zmaragdus/PortablePowerSupply/SPECIFICATIONS.md

## Top-Level Goals

Below are the overall goals of the project. All other specifications should work toward fulfilling these top-level specifications

- The unit should be the size of a large laptop charger.
- The unit should be capable of producing an adjustable output up to 27VDC and 2A (55W).
- The unit should have controls for adjusting the voltage and current limits.
- The unit should have a display to show the output voltage/current
- The unit should provide an auxiliary fixed output of 5V and 100mA (0.5W).

## Power Path / Conversion

#### Line Input

- Should be "universal" power input (100-250VAC, 47-63Hz)
- Development testing will show if X/Y capacitors and/or common-mode chokes are required.
- Line will be double fused.
- Line will have series SPST switch to cut off power.
- Three-prong connection will be used.

#### Primary AC Conversion

- Passive diode bridge will rectify AC into positive-only sine wave
- PFC converter will produce a bus voltage no less than 30V and no more than 60V 
- PFC converter must accommodate both 50Hz and 60Hz
- PFC converter will provide, at minimum, basic isolation (will use flyback topology)

#### Primary Switching Regulator

- Monolithic switching converter will produce OUT + 1V for main power supply output.
- Main PS output control performance will need to be slow to maintain good phase margin across wide output range.
- Can use either precision current DAC or ride-on-top analog circuit to follow OUT voltage.
- Use small PCB LEDs (internally-visible) to indicate outputs in regulation.

#### Linear Post-Regulator

- Output current limit must be adjustable.
- No remote sense / cable compensation for initial design.
- Precision current DAC will source/sink feedback current for coarse adjustment
- Digital potentiometer will adjust feedback resistance for fine adjustment
- Analog switch will toggle range
- Digital potentiometer will adjust current limit node.

#### Printed Circuit Board / Hardware

- To facilitate hand-soldering, it is preferred (though not required) to use either one size up in footprint size (e.g. an 0805 footprint for an 0603 capacitor) or the "hand soldering" footprint for the same size.
- No BGAs will be used. Any parts with hidden exposed pads to be soldered require a through hole large enough to get a small soldering iron tip through the other side to touch the pad for manual soldering.
- Minimum via size is 0.3mm, minimum trace/space is 0.15mm
- Layer 2 is full ground plane. Routing discipline will be used to effect minimal interference between power, analog, and digital sections.
- Vias should not be soldermasked over unless properly plugged/filled.

#### Standard Components

- Minimum resistor/capacitor size is 0402 (Imperial).
- Resistors with no extra information displayed or added as internal fields are assumed to be rated at 0603 size, 1%, 50V, 0.1W. Deviations from this will be explicitly noted.
- Resistors of other sizes assumed to have the following power ratings if not specified: 0402 = 0.06W, 0805 = .12W, 1206 = 0.25W
- Resistors with any non-standard rating(s) will have those characteristics noted as extra fields in the schematic symbol properties.
- All capacitors should have temperature range equivalent to ceramic class II X5R or better. Exceptions will be explicitly called out. (X5R or better preferred for ceramic capacitors, due to superior derating characteristics.)
- Capacitors with no extra information displayed are assumed to be ceramic MLCC type, 0603 size, and rated for 16V. Deviations from this will be explicitly noted.
- Capacitors that are part of sensitive signal circuits (control, timing, resonance, etc.) should be of class I construction (C0G or NP0 rating preferred).

## Mechanical / User

#### Line Input

- If a non-grounded connection is acceptable, plug will be IEC C8. If ground is necessary, plug will be IEC C6
- AC line input will be switch-toggled and protected (circuit breaker or user-replacable fuse)
- No ground fault monitoring.

#### Housing

- Case material undetermined at this point. Will need to be at least heat-resistant plastic. If metal, case will be earth grounded.
- Two sets of openings for airflow, one of those will have a fan mounted internally.
- All screws will be metric-threaded with a standard torx drive.
- All externally-accessible screws will be countersunk flush with case or recessed into a counterbored hole.

#### Power Output

- Main power output through two banana / mounting posts on end. Posts will accept banana plugs or wires (example: Pomona 5018 series).
- Banana posts will be standard 3/4" apart to facilitate common adapters. Could use dual post unit.
- Providing earth ground connection still under consideration.
- Auxiliary power output through two screw terminals on end.

#### User Interface

- Output voltage and current limits adjusted via independent rotary dials.
- Rotary dials connected to potentiometer.
- Output enabled/disabled through latching pushbutton.
- LED indicator for power states: LED on for output activated, LED off for output deactivated, and LED blinking for fault.
- Digital display must, at minimum, show actual output voltage and current. If additional area / capabilities exist, can also display output setpoints and any active faults (either a numeric code or an explicit statement).

## Software

The computing platform will be an Arduino Nano Every, using the standard Arduino offline IDE / compiler. This is to accommodate hobbyist and amateur usage.

If the Arduino Nano Every proves to have insufficient processing and/or memory capabilities, the ST Nucleo L432K will be used. Software will need to be migrated over to the Mbed platform in that case.

## Documentation

#### Text

LaTeX will be the primary language used for generating documentation.

The documentation will contain links to the datasheets of all

- ICs
- non-ceramic capacitors
- inductors
- filter components (e.g. ferrite bead)
- connectors
- user controls (e.g. buttons and wheels)
- PCB material specifications
- other electronic modules (e.g. display unit)

The datasheets for all ICs and modules should be downloaded and stored in the "hw/ds" folder.

#### Images

Images created in a software program will be saved as vector images (.svg) and converted to PDF files for inclusion in the LaTeX files. Use the same filename for both the .svg file and the .pdf file. This allows for batch regeneration of all images.

Images captured by a camera shall be saved as JPEG files.

All images shall be stored in the "doc/img" folder.
