zmaragdus/PortablePowerSupply/hw/sim/LT3798_design.ods

 | Value | Units
Transformer Information
NPS (pri:sec turns ratio) | 3 | -
NPB (pri:bias turns ratio) | 6 | -
LPRI (primary inductance) | 200 | uH
LLEAK (leakage inductance) | 5.9 | uH
Input/Output Information
Min Input Voltage | 100 | VAC
Input Voltage | 120 | VAC
Max Input Voltage | 130 | VAC
Target Output Voltage | 35 | VDC
Target Output Current | 2.2 | A
Diode Forward Drop | 0.55 | VDC
Rsense | 0.02 | ohm
D | 0.382 | -
IOUT(MAX) (peak) | 4.412
IOUT(MAX) (average half cycle) | 2.09589340323285
