zmaragdus/PortablePowerSupply/mech/CostEstimate.md

Initial Cost Estimate:

PCB: $45 / board, [RushPCB](https://order.rushpcb.com/#/ProtosSpecial) prototype run, 20 sq. in., 6 layers

Isolation transformer: $25 at Arrow Electronics

ICs: $70 ish at Arrow Electronics

Arduino / mbed SoM: $20-40 (many boards available on the [mbed website](https://os.mbed.com)

PCB components: $70 ish at Arrow Elecronics

Display unit: $30

Enclosure: $30?

Physical connectors / interfaces: $100 (power protection / filtering is surprisingly expensive)

Initial cost estimate: about $400 / unit
