zmaragdus/PortablePowerSupply/hw/ds/Wurth_750315827.pdf

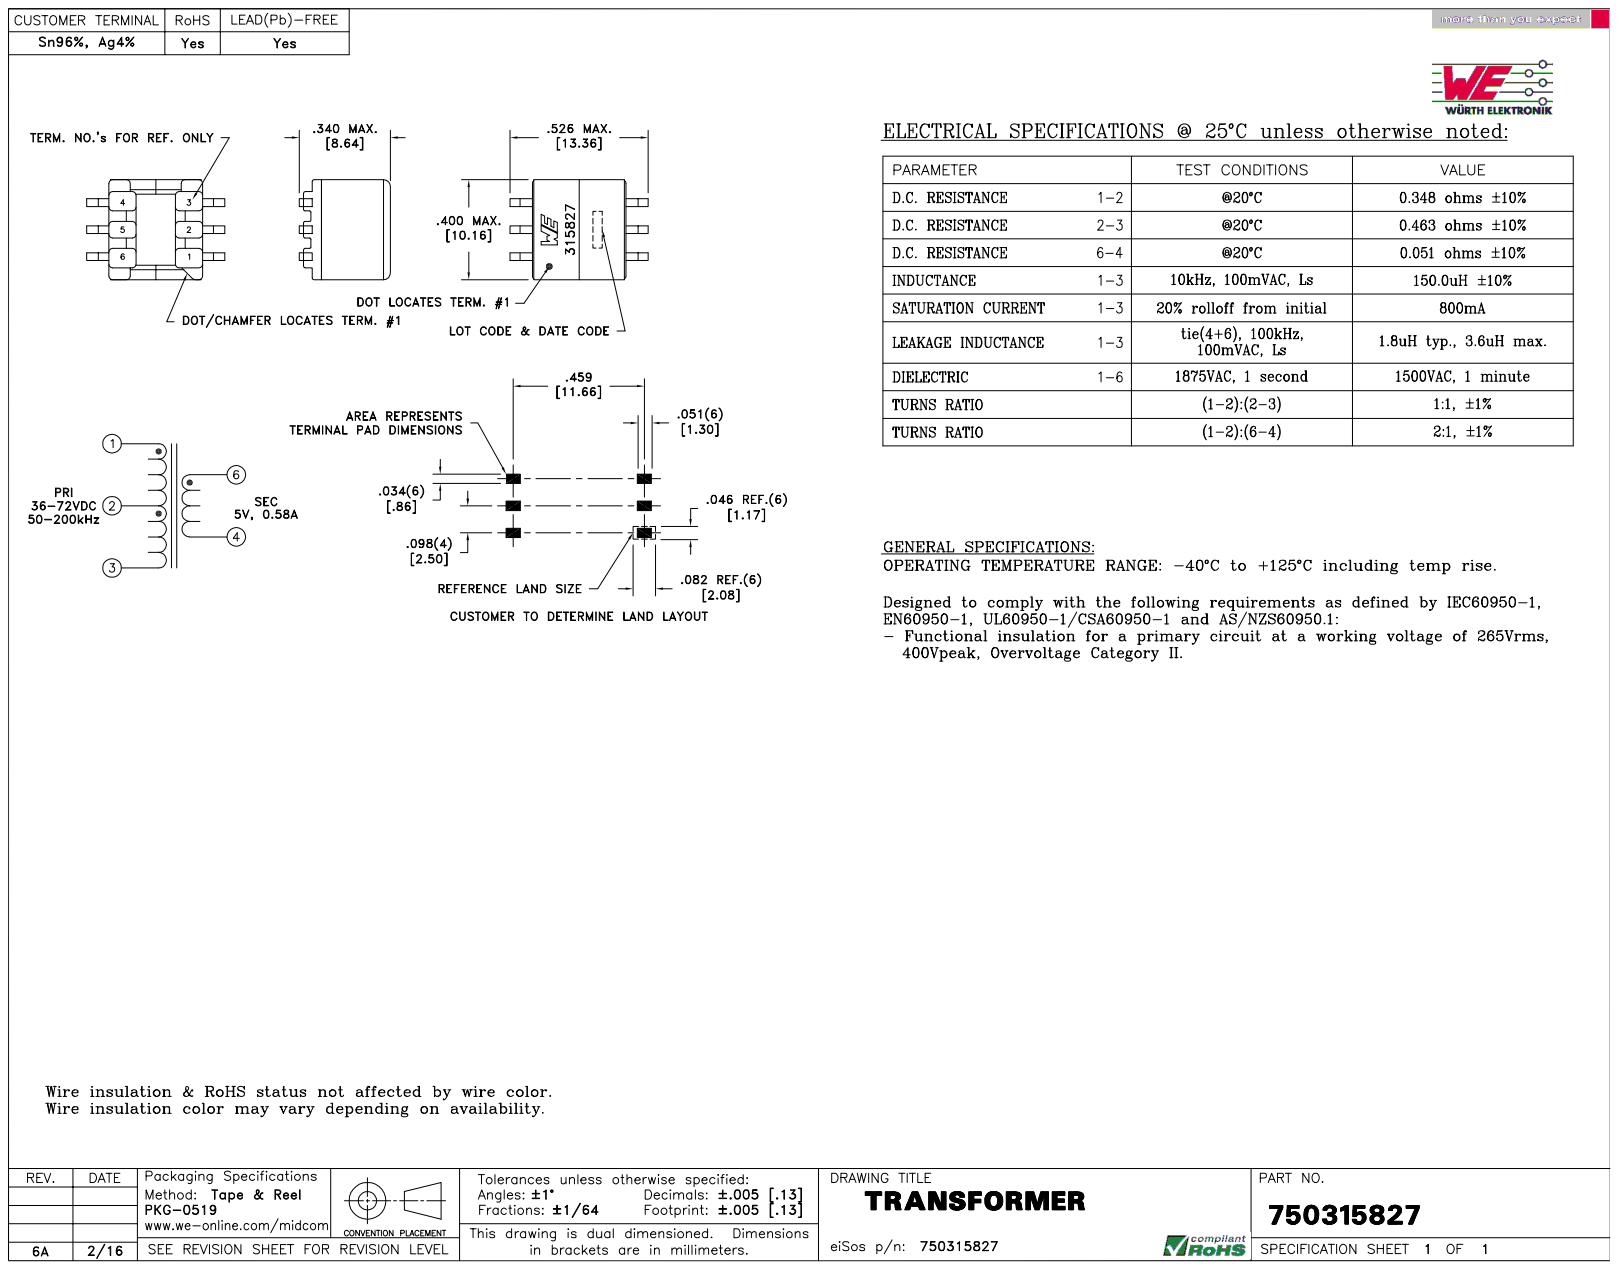
[picture p1: page 1]
