zmaragdus/PortablePowerSupply/hw/sim/constant_current_load.asc

Q1: npn; 2N3904
Q2: npn; 2N3904
R1: res; 2700
R3: res; 10
V1: voltage; PULSE(0 27 0 100m 1n 200m 400m)
V2: voltage; 5
Named nets: 0
.tran 100m
.temp -10 5 20 35 50 65 80 95 110
