zmaragdus/PortablePowerSupply/(threads)

Thread 5 (2020-05-26):

Generate DAC Code Equations

zmaragdus, 2020-05-26:
Create equations for current DAC outputs to adjust voltages / current limit.

zmaragdus, 2020-05-26:
Download "LTPowerCAD II" from Analog Devices' website. They have a tool for calculating LTC7106 operation under "toolbox"

Thread 6 (2020-05-26):

Choose ADC

zmaragdus, 2020-05-26:
Need ADC for measuring up to four rails: switching regulator output voltage, linear regulator output voltage, linear regulator current monitor, linear regulator temperature monitor.

Can use precision resistor dividers to bring voltage in-range.

Possible voltage supply rails: 36V, 5V, 3.3V, 1.8V

I2C or SPI preferred. (Will depend on selected microcontroller)

zmaragdus, 2020-05-26:
Cheapest single-channel ADC on Analog Devices' website is almost $6. Will be cheaper to get a multi-channel unit.

Target bit range in excess of 14 bits.

Rough calculations: for 14-bit converter with 4.096V reference, LSB size is 250uV. If max switcher voltage is 28V, that gives an ideal resolution of about 1.7mV / bit on the primary sw output reading.

zmaragdus, 2020-05-30:
Chose AD7682

Closed 2020-05-30.

Thread 14 (2021-02-10):

Aux Transformer Footprint

zmaragdus, 2021-02-10:
Need footprint for auxiliary output transformer to finish subsystem

part number: Wurth 750315827

datasheet: https://www.we-online.de/katalog/datasheet/750315827.pdf
