zmaragdus/PortablePowerSupply/(commit log)

2020-05-06 Initial Commit
    Initial commit. Already done with a lot of the greater schematic
    [LineInput.sch, LinearReg.sch, PFCBoost.sch, PrimarySW.sch, SupplyAdj.sch, portaPower.kicad_pcb, portaPower.sch]
2020-05-06 Reorg
    Reorganized folder structure
    [LineInput.sch, LinearReg.sch, PFCBoost.sch, PrimarySW.sch, SupplyAdj.sch, portaPower.kicad_pcb, portaPower.sch]
2020-05-07 More work on PFC
    Added more circuitry to PFC boost converter; about half done
    [LineInput.sch, PFCBoost.sch, portaPower.sch]
2020-05-09 Primary SW component selection
    selected some components for primary switcher, added AuxOut block, dropped down primary linear reg IC
    [AuxOut.sch, LineInput.sch, LinearReg.sch, PFCBoost.sch, PrimarySW.sch, SupplyAdj.sch, portaPower.sch]
2020-05-09 Cap selections
    Lots of capacitor selections & datasheet downloads
    Updated LTPowerCAD model with initial compensation values for primary switcher
    [LineInput.sch, LinearReg.sch, PFCBoost.sch, PrimarySW.sch, SupplyAdj.sch]
2020-05-15 more component selection
    more caps selected; updated primary switcher sim file
    [LineInput.sch, LinearReg.sch, PFCBoost.sch, PrimarySW.sch, SupplyAdj.sch]
2020-05-19 reorg
    expanded readme, added more specs, large file structure reorg
    [AuxOut.sch, LineInput.sch, LinearReg.sch, PFCBoost.sch, PrimarySW.sch, SupplyAdj.sch, portaPower.kicad_pcb, portaPower.sch]
2020-05-19 added gitignore
    initially ignoring only KiCad backup files
2020-05-20 updated libraries, new xfmr
    updated libraries, selected transformer and added to library/documentation
    [LineInput.sch, LinearReg.sch, PFCBoost.sch, PrimarySW.sch, SupplyAdj.sch, portaPower.sch]
2020-05-20 more work
    more PFC work, more LDO work, added secondary regulator sheet, expanded system power tree sim
    [AuxOut.sch, LineInput.sch, LinearReg.sch, PFCBoost.sch, PrimarySW.sch, SecRegulators.sch, SupplyAdj.sch, portaPower.sch]
2020-05-20 more power tree details
    broke out more load components, color coded some items
2020-05-24 lots of work
    expanded README doc, specifications, added secondary regulator circuit + symbol, more component specs added
    [AuxOut.sch, LinearReg.sch, PFCBoost.sch, PrimarySW.sch, SecRegulators.sch, SupplyAdj.sch, portaPower.sch]
2020-05-25 fixed link
    link to inkscape had curly bracket instead of parentheses; fixed
2020-05-25 removed line breaks
    removed line breaks, changed "metric & torx" spec from external-only to all screws
2020-05-25 updated PFC components
    adjusted resistor sized, specified INTvcc capacitor
    [PFCBoost.sch]
2020-05-25 more part numbers
    Added manfacturer part numbers to ICs, added descriptions to symbols in library
    [LinearReg.sch, PFCBoost.sch, PrimarySW.sch, SecRegulators.sch, SupplyAdj.sch]
2020-05-30 added ADC circuitry
    added ADC and associating circuitry; need to adjust voltage dividers/filters and connect to rest of system
    [AuxOut.sch, LineInput.sch, LinearReg.sch, PFCBoost.sch, PrimarySW.sch, RegMonitor.sch, SecRegulators.sch, SupplyAdj.sch]
2021-02-10 architecture reorg
    Large architecture reorg; added and finished aux 5V output; started arduino code
    [IsoFlyback.sch, LineFilter.sch, PFCFlyback.sch, pin_assignment.ods]
2021-02-13 aux output, documentation
    finished aux output circuit, updated a lot of documentation, added datasheets
    [AuxOut.sch, LineFilter.sch, LinearReg.sch, PFCFlyback.sch, SupplyAdj.sch, SysPower.sch, portaPower.sch]
2021-02-15 reworked adjusters
    new V/I adjustment scheme; modified LDO circuit to match
    [AuxOut.sch, LinearReg.sch, SupplyAdj.sch, SysPower.sch, portaPower.sch]
2021-02-15 label/net reorg, primary SW starting
    some reorganization of top-level naming for nets and hierarchical pins
    fixed a few part selection issues
    started on primary switcher sheet
    [AuxOut.sch, LineFilter.sch, LinearReg.sch, PFCFlyback.sch, PrimarySW.sch, SupplyAdj.sch, SysPower.sch, portaPower.sch]
2021-03-10 DS repo cleanup
    cleaned up repository of datasheets
    [LT3798_design.ods]
2021-04-10 sims, new devices, code started
    made some simulations & calculations, started working on code (moved devices into individual header files), new devices chosen in library
    [AuxOut.sch, LinearReg.sch, PrimarySW.sch, code_sweep.ods]
2021-05-22 rearchitect
    new primary switcher : LT8637
    [PrimarySW.sch]
